Izolentiy/line_following/images/electrical_scheme.pdf

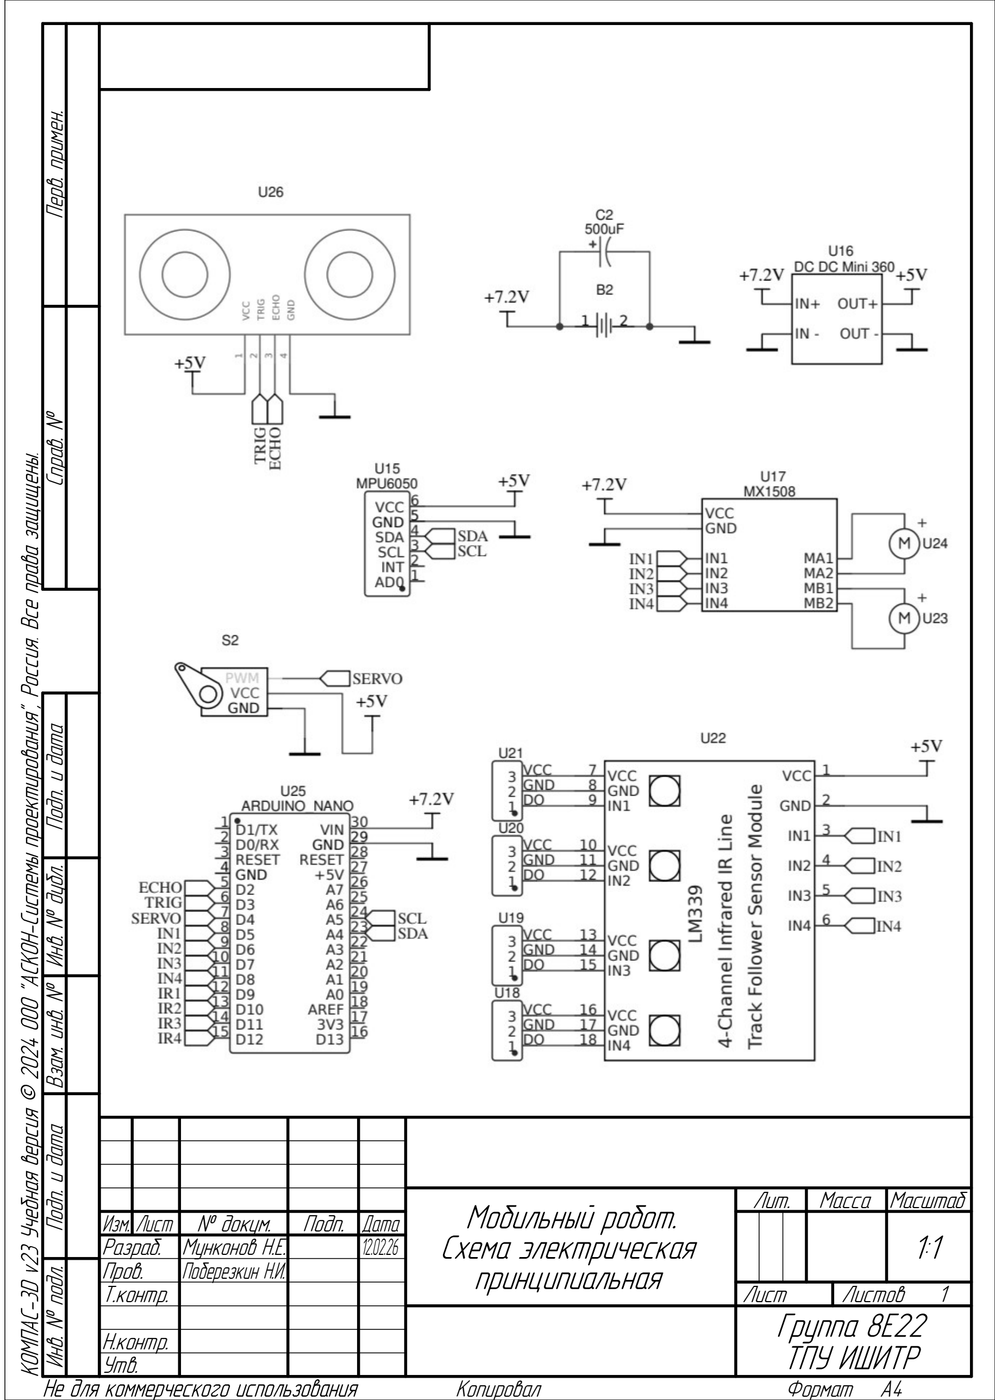
[picture p8: page 1]

| | | | Мобильный робот. Схема электрическая принципиальная | Лит. | Масса | Масштаб
Изм. Лист | № докум. | Подп. | Дата | | | | | 1:1
Разраб. | Мунконов Н.Е. | | 12.02.26
| Пров. | Поберезкин Н.И.
Т.контр. | | | | Лист | Листов 1

Н.контр.
Утв.
Группа 8Е22 Инв. № подл. Подп. и дата Взам. инв. № Инв. № дубл. Подп. и дата | ТПУ ИШИТР Справ. № Перв. примен.
Копировал | Формат A4
