Izolentiy/line_following/include/maze_solving.h

#pragma once
#include "common.h"
#include "action.h"

LinearMoveByTimer moveStraight6cm(300);
LinearMoveByTimer moveBack3cm(150, false);

int freeLeft = 0;
int lastDistanceFront = 0;
int stuckCounter = 0;
bool needToMoveForward = false;

// left-hand rule
void mazeSolvingLeft() {
  int distanceLeft = preciseDistanceOn(LEFT);
  int distanceFront = preciseDistanceOn(FRONT);

  if (distanceLeft > 30) {
    if (needToMoveForward) {
      blockingPerform(&turnRight);
      blockingPerform(&moveStraight3cm);
      blockingPerform(&turnLeft);
      blockingPerform(&moveStraight3cm);
    }
    if (freeLeft > 0) {
      blockingPerform(&turnLeft);
      blockingPerform(&moveStraight5cm);
      freeLeft = 0;
      needToMoveForward = true;
    } else {
      freeLeft++;
    }
  } else if (distanceFront < 10) {
    blockingPerform(&turnRight);
    needToMoveForward = false;
    return;
  } else {
    needToMoveForward = false;
  }

  // the front distance doesn't change - the robot is stuck
  if (abs(lastDistanceFront - distanceFront) < 2) {
    stuckCounter++;
  } else {
    stuckCounter = 0;
  }
  if (stuckCounter > 2) {
    blockingPerform(&moveBack3cm);
    blockingPerform(&turnLeft);
    blockingPerform(&moveStraight5cm);
    blockingPerform(&turnRight);
    stuckCounter = 0;
  }
  blockingPerform(&moveStraight3cm);

  lastDistanceFront = distanceFront;
}

// right-hand rule
void mazeSolvingRight() {
  if (preciseDistanceOn(RIGHT) > 30) {
    PRINT("\nTURNING RIGHT\n");
    blockingPerform(&moveStraight6cm);
    blockingPerform(&turnRight);
    blockingPerform(&moveStraight5cm);
  } else if (preciseDistanceOn(FRONT) < 10) {
    PRINT("\nTURNING LEFT\n");
    blockingPerform(&turnLeft);
  } else {
    PRINT("\nMOVING FORWARD\n");
    blockingPerform(&moveStraight3cm);
  }
}

void mazeSolving() {
  mazeSolvingLeft();
}
