Izolentiy/line_following/(commit log)

2026-01-30 начал работу над поворотом на месте
2026-02-02 код Данилы
2026-02-03 код для каждого алгоритма вынесен в отдельные файлы
2026-02-06 новая концепция построения программ для робота
2026-02-10 все что наработал
2026-02-10 лабиринт пробник
2026-02-11 большой рефакторинг
2026-02-11 всё работает с горем пополам
2026-10-14 Самая новая версия алгоритмов
2026-10-20 Подчистил код, добавил README
2026-10-20 Исправил неточность в README
